YarekTyshchenko/KJ-22/box/export.FCStd

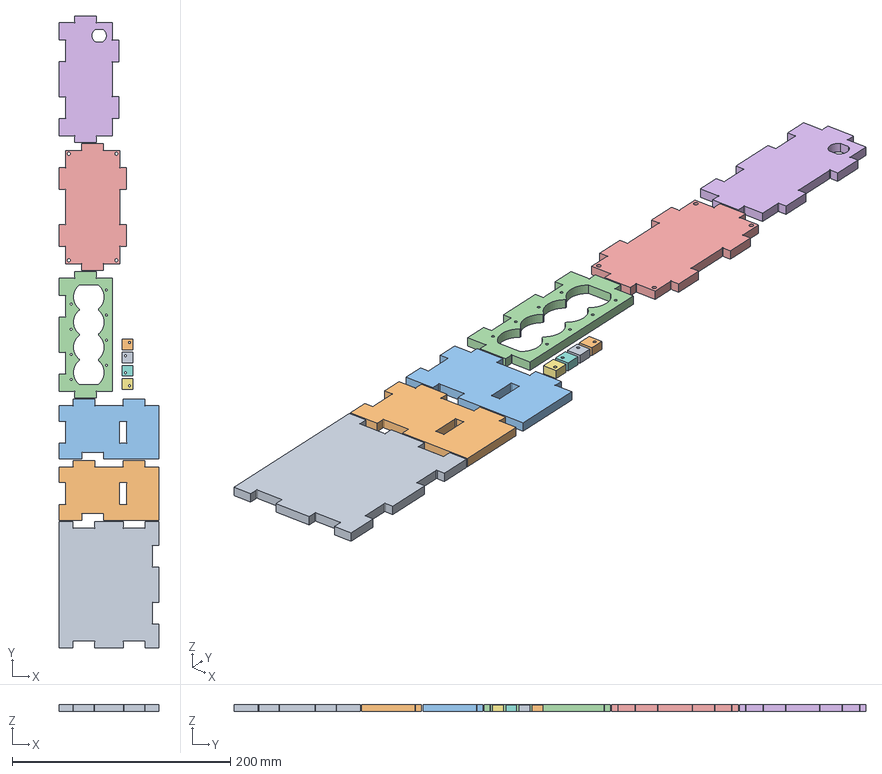
[picture p1: CAD file, 2021-09-22]
box/export.FCStd
92.0 x 579.0 x 6.00 mm
test
test001
test002
test003
test004
test005
test006
test007
test008
test009
