YarekTyshchenko/KJ-22/box/Box-test.FCStd

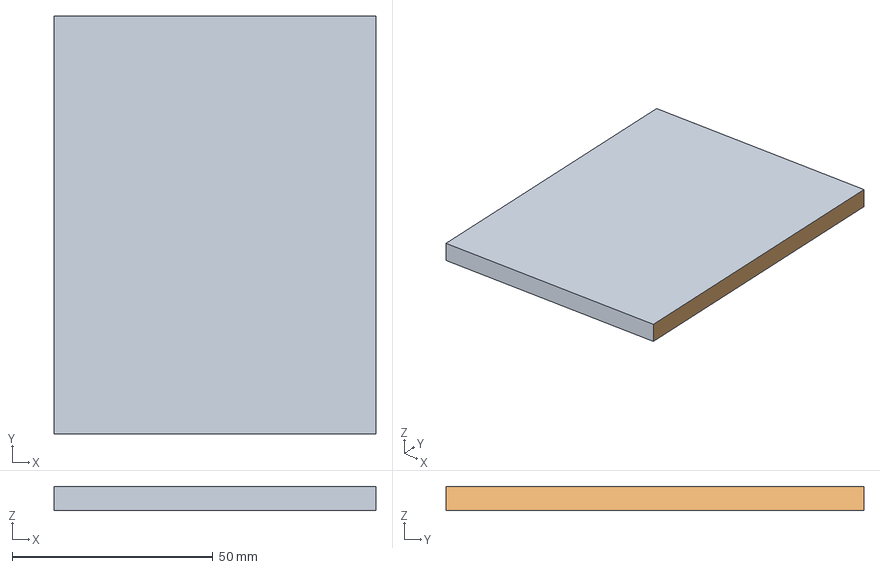
[picture p2: CAD file, 2021-09-22]
box/Box-test.FCStd
80.0 x 104.0 x 6.00 mm
bottom_panel002
