YarekTyshchenko/KJ-22/box/Foo.FCStd

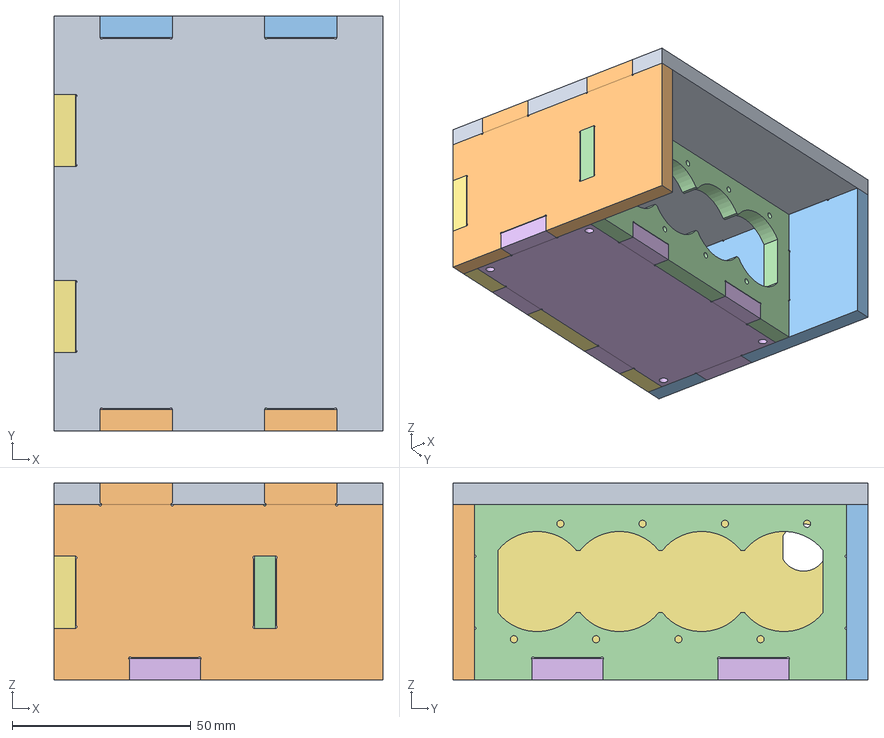
[picture p3: CAD file, 2021-05-18]
box/Foo.FCStd
92.0 x 116.0 x 55.0 mm
top_panel001_tab
right_panel001_tab
left_panel001_tab
Front panel
Corner Bracket
Bottom Panel
Back Panel
Corner Bracket (Mirror #1)
Corner Bracket (Mirror #2)
Corner Bracket (Mirror #3)
