YarekTyshchenko/KJ-22/box/Box 6mm.FCStd

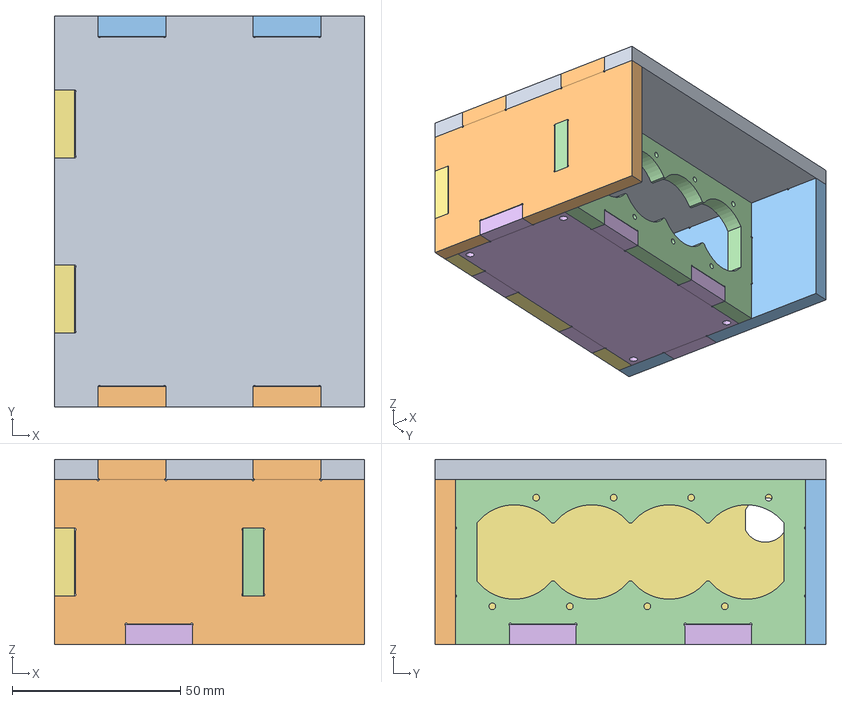
[picture p4: CAD file, 2021-05-18]
box/Box 6mm.FCStd
92.0 x 116.0 x 55.0 mm
top_panel001_tab
right_panel001_tab
left_panel001_tab
Front panel
Corner Bracket
Bottom Panel
Back Panel
Corner Bracket (Mirror #1)
Corner Bracket (Mirror #2)
Corner Bracket (Mirror #3)
