YarekTyshchenko/KJ-22/box/box_6mm Walnut.dxf

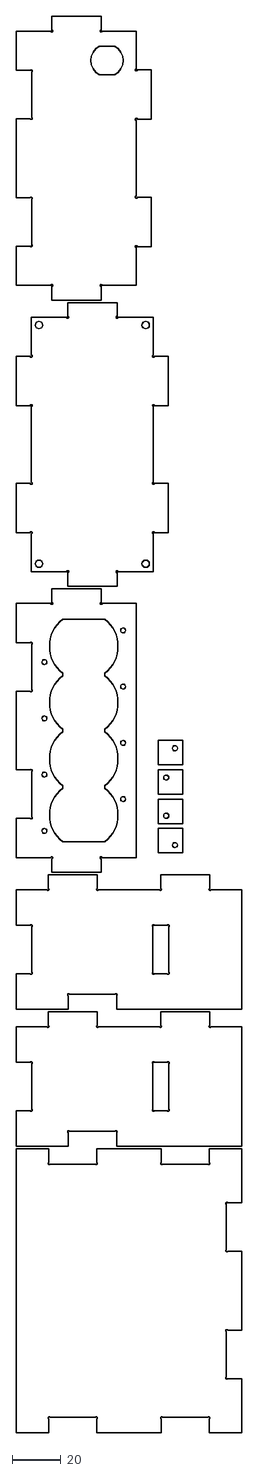
[picture p5: CAD file, 2021-05-18]
box/box_6mm Walnut.dxf
92.0 x 579.0
