YarekTyshchenko/KJ-22/box/Box 5.7mm.FCStd

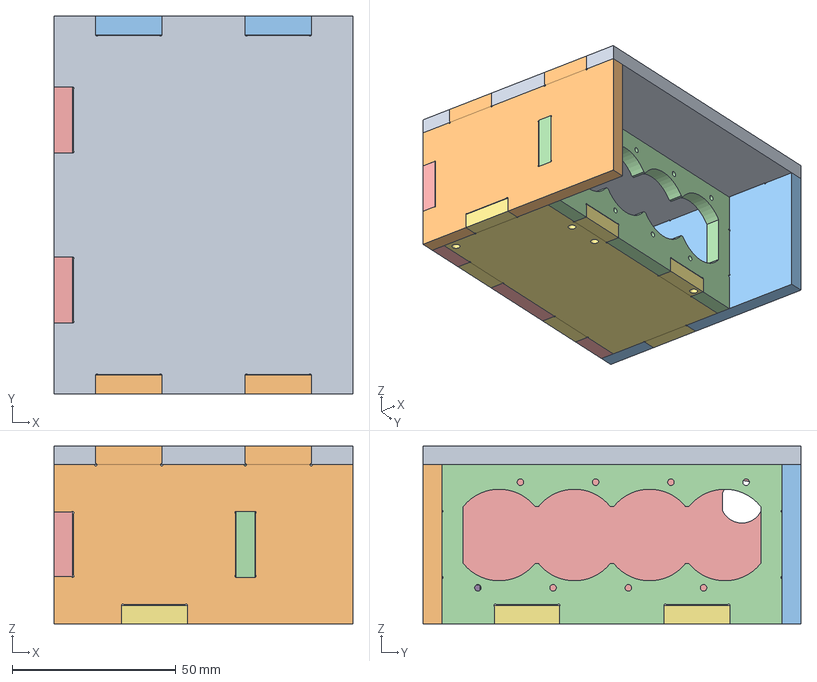
[picture p6: CAD file, 2021-05-18]
box/Box 5.7mm.FCStd
91.4 x 115.4 x 54.4 mm
top_panel001_tab
right_panel001_tab
left_panel001_tab
Front panel
Corner Bracket
Bottom Panel
