YarekTyshchenko/KJ-22/(list of files, cad)

Other CAD files:
box/laser-cut-box.FCStd
box/KJ-22 project box.skp
box/box_test.dxf
box/laser-cut-box.blend
