YarekTyshchenko/KJ-22/main_v2.brd

## EAGLE design main_v2.brd (2021-04-18)

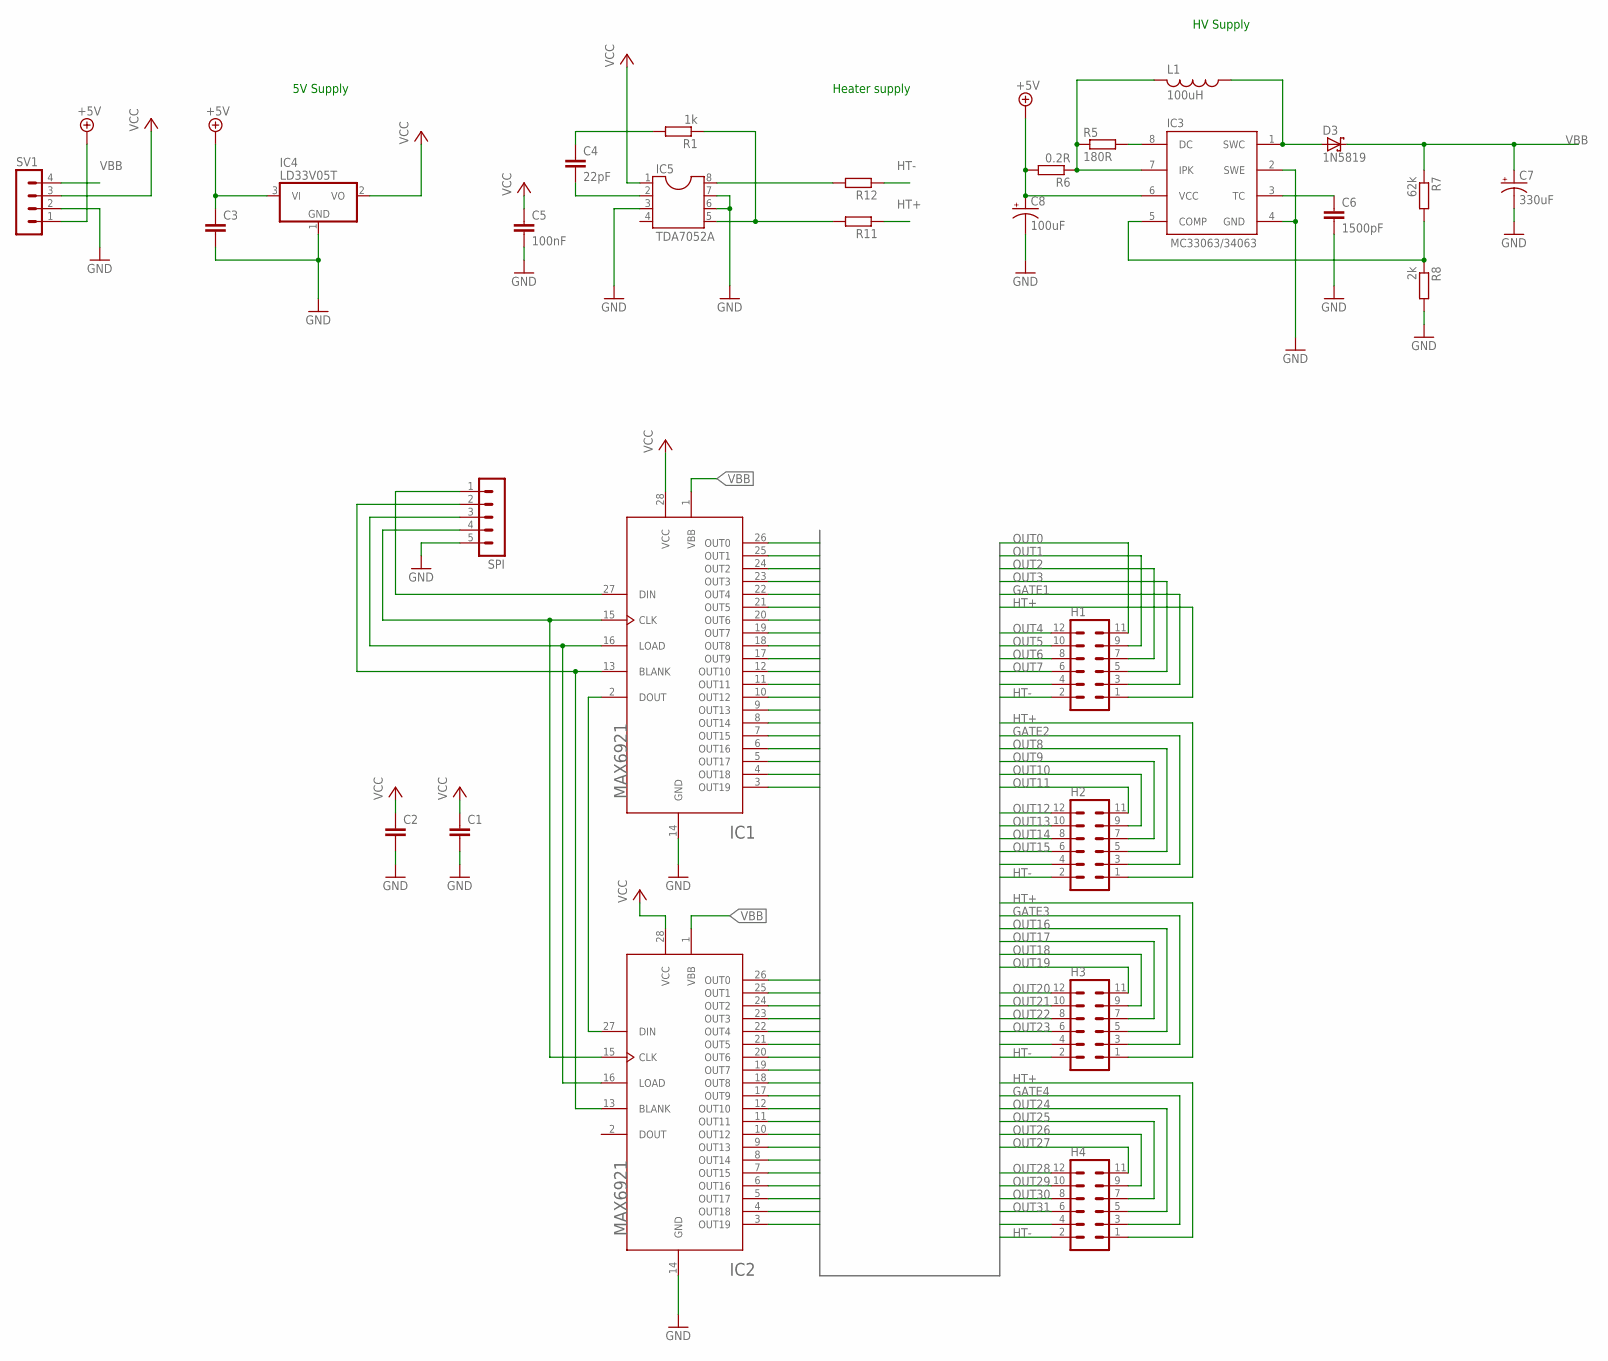
[picture p7: schematic main_v2.sch]

Parts:
C1, C2, C3: C-EU025-025X050; C025-025X050
C4: 22pF; C025-025X050
C5: 100nF; C025-025X050
C6: 1500pF; C025-025X050
C7: 330uF; E3,5-8
C8: 100uF; E2,5-5
D3: 1N5819; DO35-7
H1, H2, H3, H4: MA06-2
IC1, IC2: MAX6921; PLCC-S28
IC3: MC33063; DIL08
IC4: LD33V05T; TO220H
IC5: TDA7052A; DIL08
L1: 100uH; 6000-XXXX-RC
R1: 1k; 0204/7
R5: 180R; 0204/7
R6: 0.2R; 0207/10
R7: 62k; 0204/7
R8: 2k; 0204/7
R11, R12: R-EU_0204/7; 0204/7
SPI: MA05-1
SV1: MA04-1

Connections:
+5V: C3.1, C8.+, IC3.6 (VCC), IC4.3 (VI), R6.2, SV1.1
GATE1: H1.3, IC2.12 (OUT10)
GATE2: H2.3, IC2.18 (OUT8)
GATE3: H3.3, IC1.12 (OUT10)
GATE4: H4.3, IC1.25 (OUT1)
GND: C1.2, C2.2, C3.2, C5.2, C6.2, C7.-, C8.-, IC1.14 (GND), IC2.14 (GND), IC3.2 (SWE), IC3.4 (GND), IC4.1 (GND), IC5.3, IC5.6, IC5.7, R8.2, SPI.5, SV1.2
HT+: H1.1, H2.1, H3.1, H4.1, R11.1
HT-: H1.2, H2.2, H3.2, H4.2, R12.1
MOSI: IC1.27 (DIN), SPI.1
unnamed: IC1.2 (DOUT), IC2.27 (DIN)
unnamed: IC5.8, R12.2
unnamed: IC1.13 (BLANK), IC2.13 (BLANK), SPI.2
unnamed: IC1.16 (LOAD), IC2.16 (LOAD), SPI.3
unnamed: C6.1, IC3.3 (TC)
unnamed: IC5.5, R1.1, R11.2
unnamed: D3.A, IC3.1 (SWC), L1.1
unnamed: IC3.7 (IPK), L1.2, R5.1, R6.1
unnamed: IC3.8 (DC), R5.2
unnamed: C4.2, IC5.2
unnamed: IC3.5 (COMP), R7.2, R8.1
unnamed: C4.1, R1.2
OUT0: H1.11, IC2.10 (OUT12)
OUT1: H1.9, IC2.7 (OUT15)
OUT2: H1.7, IC2.5 (OUT17)
OUT3: H1.5, IC2.11 (OUT11)
OUT4: H1.12, IC2.9 (OUT13)
OUT5: H1.10, IC2.8 (OUT14)
OUT6: H1.8, IC2.6 (OUT16)
OUT7: H1.6, IC2.3 (OUT19)
OUT8: H2.5, IC2.21 (OUT5)
OUT9: H2.7, IC2.23 (OUT3)
OUT10: H2.9, IC2.25 (OUT1)
OUT11: H2.11, IC2.19 (OUT7)
OUT12: H2.12, IC2.20 (OUT6)
OUT13: H2.10, IC2.26 (OUT0)
OUT14: H2.8, IC2.24 (OUT2)
OUT15: H2.6, IC2.22 (OUT4)
OUT16: H3.5, IC1.11 (OUT11)
OUT17: H3.7, IC1.8 (OUT14)
OUT18: H3.9, IC1.9 (OUT13)
OUT19: H3.11, IC1.10 (OUT12)
OUT20: H3.12, IC1.7 (OUT15)
OUT21: H3.10, IC1.6 (OUT16)
OUT22: H3.8, IC1.5 (OUT17)
OUT23: H3.6, IC1.3 (OUT19)
OUT24: H4.5, IC1.23 (OUT3)
OUT25: H4.7, IC1.21 (OUT5)
OUT26: H4.9, IC1.22 (OUT4)
OUT27: H4.11, IC1.19 (OUT7)
OUT28: H4.12, IC1.20 (OUT6)
OUT29: H4.10, IC1.18 (OUT8)
OUT30: H4.8, IC1.17 (OUT9)
OUT31: H4.6, IC1.24 (OUT2)
SCK: IC1.15 (CLK), IC2.15 (CLK), SPI.4
SPARE1: H1.4, IC2.4 (OUT18)
SPARE2: H2.4, IC2.17 (OUT9)
SPARE3: H3.4, IC1.4 (OUT18)
SPARE4: H4.4, IC1.26 (OUT0)
VBB: C7.+, D3.C, IC1.1 (VBB), IC2.1 (VBB), R7.1, SV1.4
VCC: C1.1, C2.1, C5.1, IC1.28 (VCC), IC2.28 (VCC), IC4.2 (VO), IC5.1, SV1.3

Notes on the sheet:
Heater supply
HV Supply
5V Supply

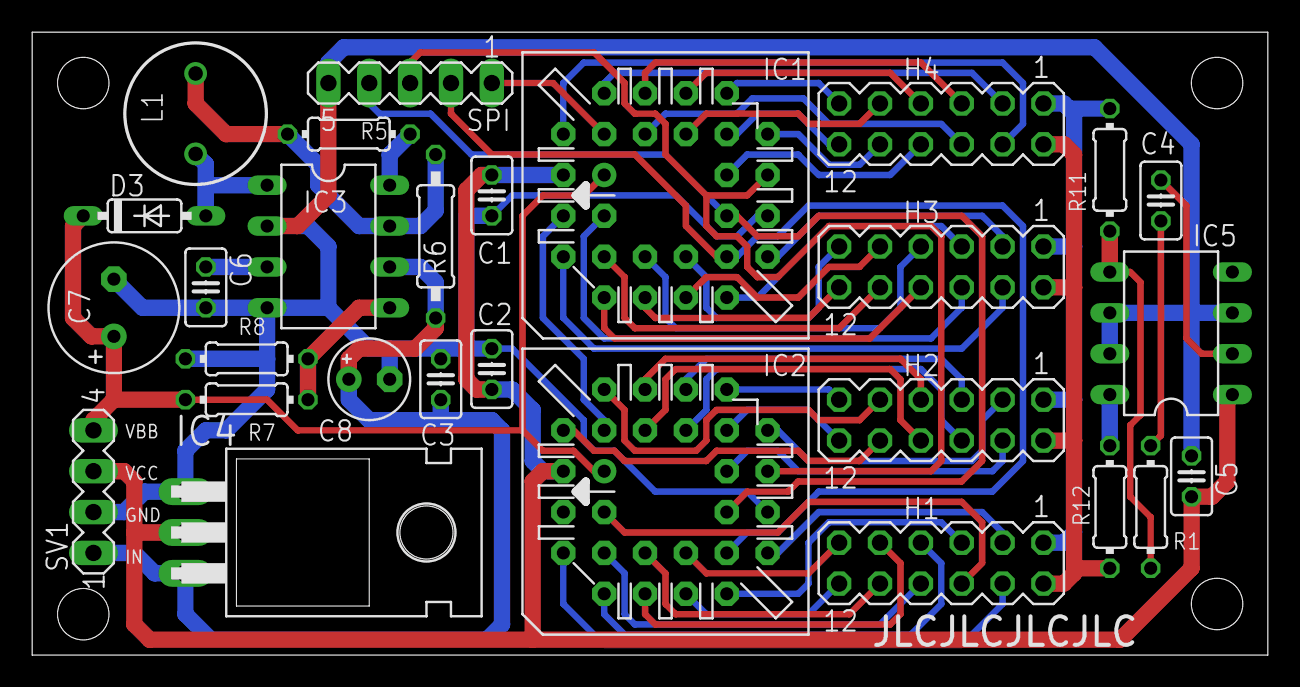
[picture p8: board main_v2.brd from above]

Board: 2 copper layers, 76.8 x 38.7 mm, 28 parts (0 on the bottom side), 60 nets.
