YarekTyshchenko/KJ-22/main_v1.brd

## EAGLE design main_v1.brd (2018-06-11, an earlier design)

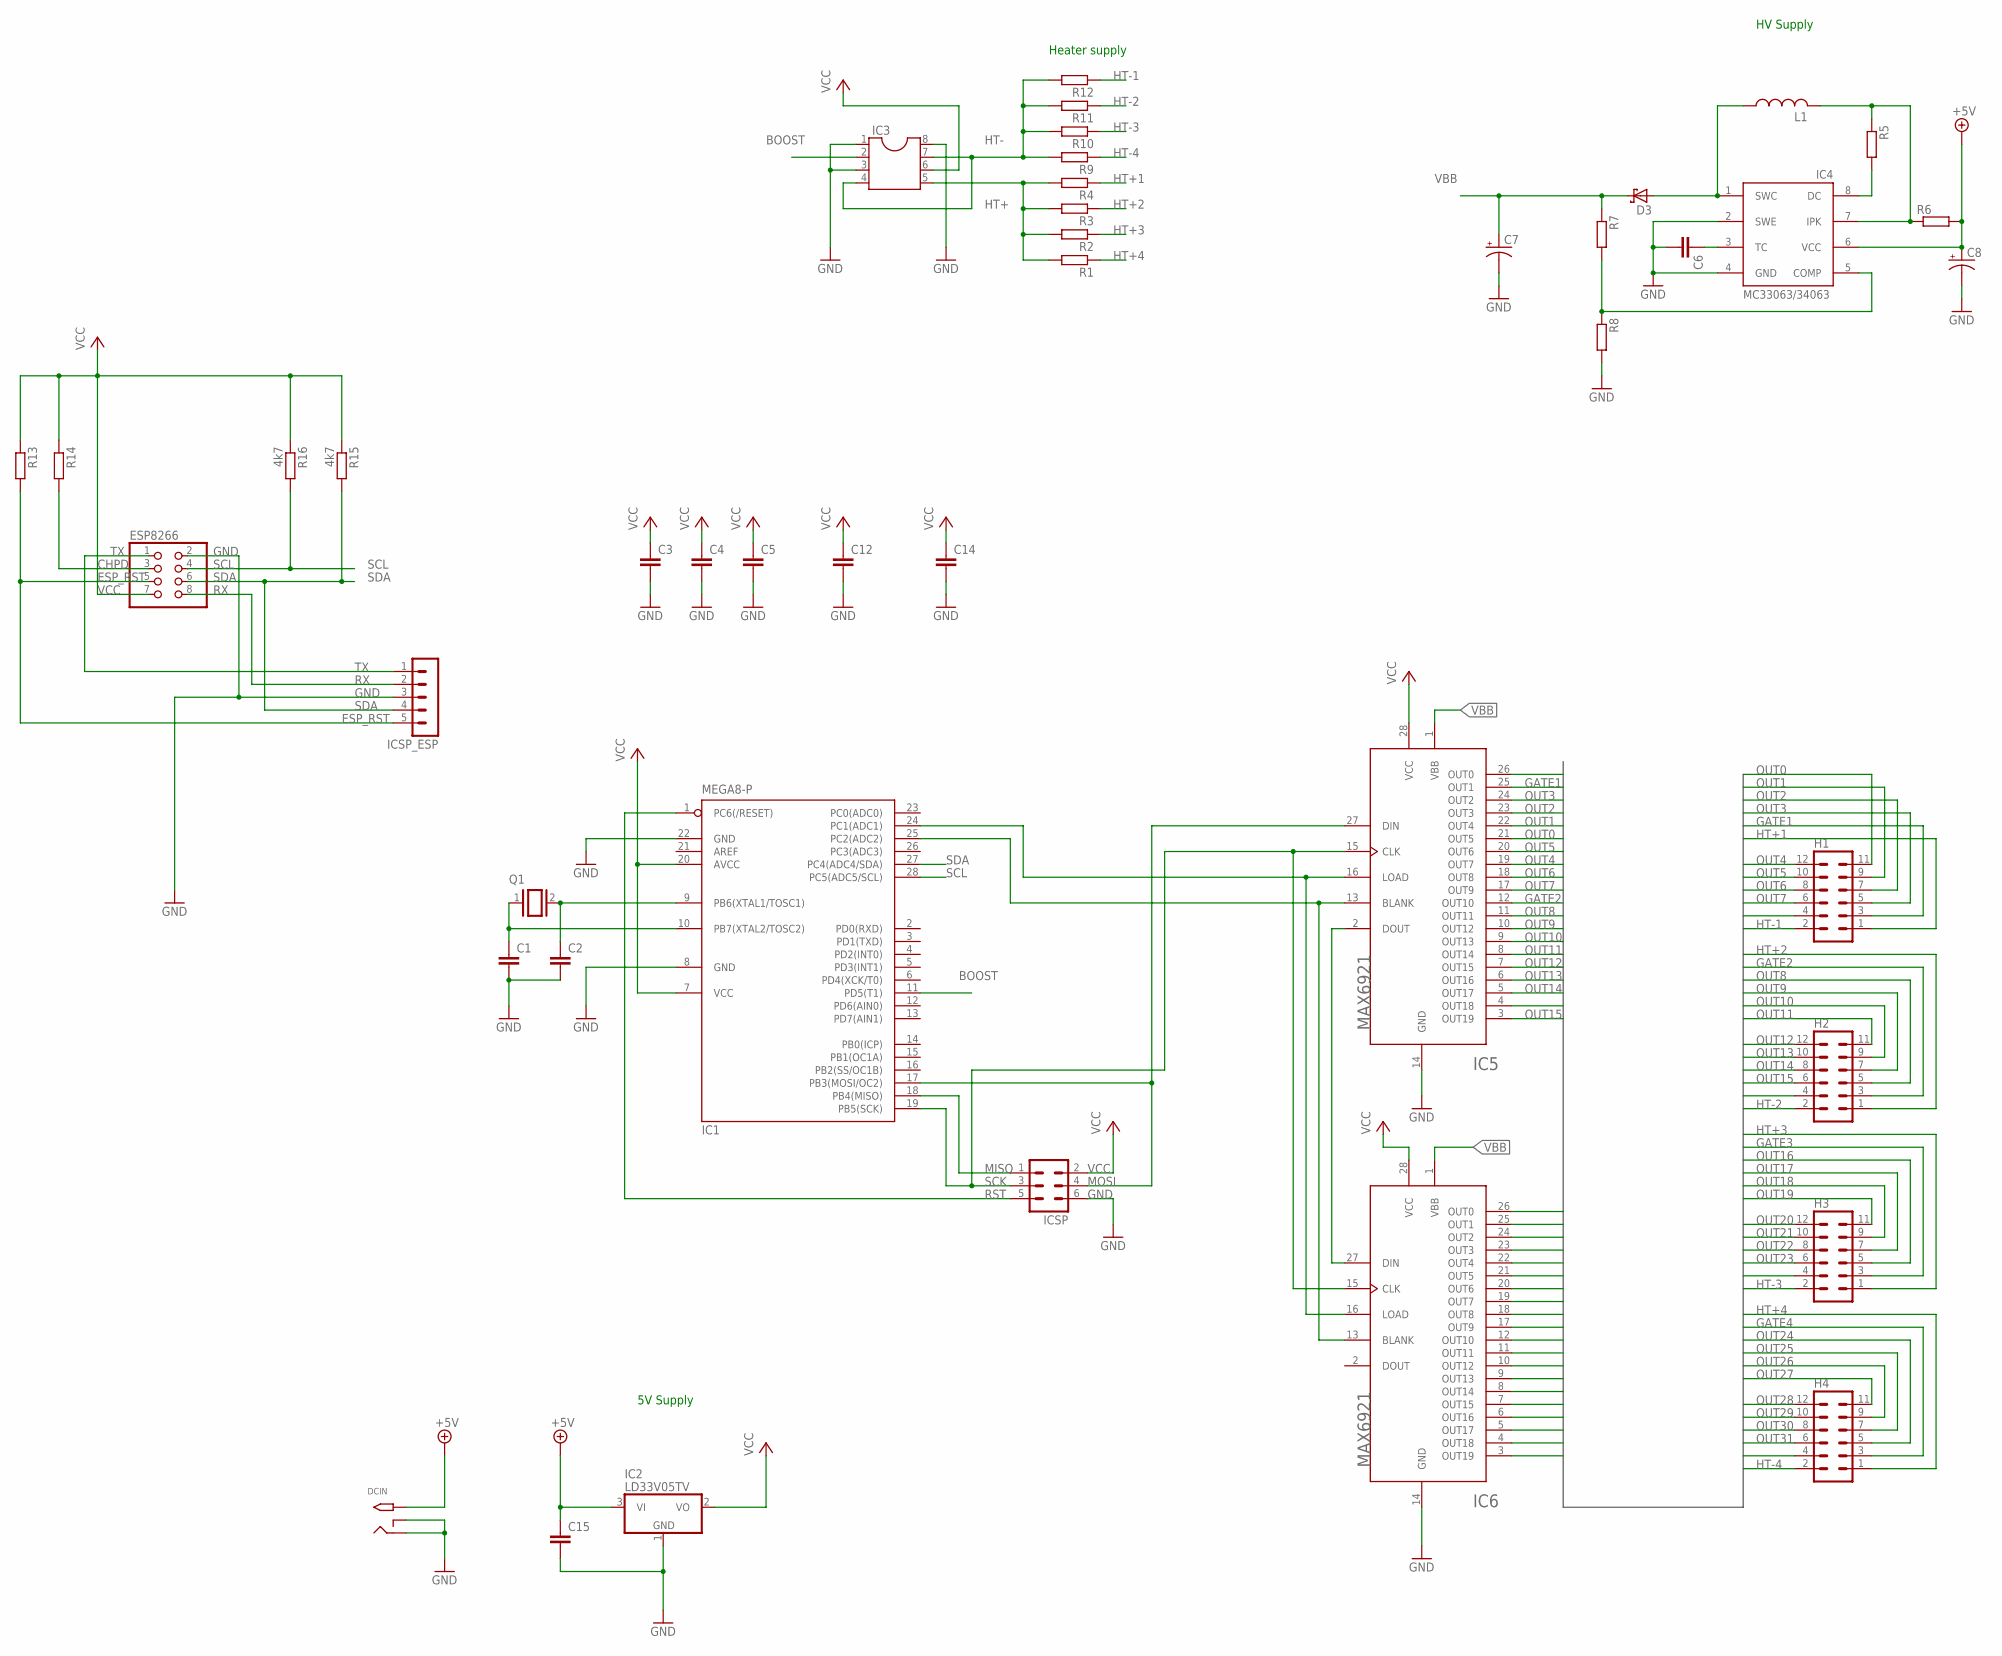
[picture p9: schematic main_v1.sch]

Parts:
C1, C2: C2.5/2; C2.5-2
C3, C4, C5, C6, C12, C14, C15: C-EU025-025X050; C025-025X050
C7: CPOL-USE3.5-8; E3,5-8
C8: CPOL-USE2.5-5; E2,5-5
D3: SCHOTTKY-DIODEDO35-7; DO35-7
DCIN: 2.1MMJACKTHM; PJ-102A
ESP8266: PINHD-2X4; 2X04
H1, H2, H3, H4: MA06-2
IC1: MEGA8-P; DIL28-3
IC2: LD33V05TV; TO220V
IC3: DIL8; DIL08
IC4: MC33063/MC34063P; DIL08
IC5, IC6: MAX6921; PLCC-S28
ICSP: MA03-2
ICSP_ESP: MA05-1
L1: L-US6000-XXX-RC; 6000-XXXX-RC
Q1: XTAL/S; QS
R1, R2, R3, R4, R5, R6, R7, R8, R9, R10, R11, R12, R14: R-EU_0204/7; 0204/7
R13: R-EU_0207/10; 0207/10
R15, R16: 4k7; 0204/7

Connections:
+5V: C8.+, C15.1, DCIN.TIP, IC2.3 (VI), IC4.6 (VCC), R6.2
BOOST: IC1.11 (PD5(T1)), IC3.2
CHPD: ESP8266.3, R14.2
ESP_RST: ESP8266.5, ICSP_ESP.5, R13.2
GATE1: H1.3, IC5.25 (OUT1)
GATE2: H2.3, IC5.12 (OUT10)
GATE3: H3.3, IC6.25 (OUT1)
GATE4: H4.3, IC6.12 (OUT10)
GND: C1.2, C2.2, C3.2, C4.2, C5.2, C6.2, C7.-, C8.-, C12.2, C14.2, C15.2, DCIN.RING, DCIN.RING_SW, ESP8266.2, IC1.8 (GND), IC1.22 (GND), IC2.1 (GND), IC3.1, IC3.3, IC3.8, IC4.2 (SWE), IC4.4 (GND), IC5.14 (GND), IC6.14 (GND), ICSP.6, ICSP_ESP.3, R8.2
HT+: IC3.5, R1.2, R2.2, R3.2, R4.2
HT+1: H1.1, R4.1
HT+2: H2.1, R3.1
HT+3: H3.1, R2.1
HT+4: H4.1, R1.1
HT-: IC3.4, IC3.7, R9.2, R10.2, R11.2, R12.2
HT-1: H1.2, R12.1
HT-2: H2.2, R11.1
HT-3: H3.2, R10.1
HT-4: H4.2, R9.1
MISO: IC1.18 (PB4(MISO)), ICSP.1
MOSI: IC1.17 (PB3(MOSI/OC2)), IC5.27 (DIN), ICSP.4
unnamed: IC5.2 (DOUT), IC6.27 (DIN)
unnamed: C1.1, IC1.10 (PB7(XTAL2/TOSC2)), Q1.1
unnamed: IC1.25 (PC2(ADC2)), IC5.13 (BLANK), IC6.13 (BLANK)
unnamed: IC1.24 (PC1(ADC1)), IC5.16 (LOAD), IC6.16 (LOAD)
unnamed: C6.1, IC4.3 (TC)
unnamed: C2.1, IC1.9 (PB6(XTAL1/TOSC1)), Q1.2
unnamed: D3.A, IC4.1 (SWC), L1.1
unnamed: IC4.7 (IPK), L1.2, R5.1, R6.1
unnamed: IC4.8 (DC), R5.2
unnamed: IC4.5 (COMP), R7.2, R8.1
OUT0: H1.11, IC5.21 (OUT5)
OUT1: H1.9, IC5.22 (OUT4)
OUT2: H1.7, IC5.23 (OUT3)
OUT3: H1.5, IC5.24 (OUT2)
OUT4: H1.12, IC5.19 (OUT7)
OUT5: H1.10, IC5.20 (OUT6)
OUT6: H1.8, IC5.18 (OUT8)
OUT7: H1.6, IC5.17 (OUT9)
OUT8: H2.5, IC5.11 (OUT11)
OUT9: H2.7, IC5.10 (OUT12)
OUT10: H2.9, IC5.9 (OUT13)
OUT11: H2.11, IC5.8 (OUT14)
OUT12: H2.12, IC5.7 (OUT15)
OUT13: H2.10, IC5.6 (OUT16)
OUT14: H2.8, IC5.5 (OUT17)
OUT15: H2.6, IC5.3 (OUT19)
OUT16: H3.5, IC6.24 (OUT2)
OUT17: H3.7, IC6.23 (OUT3)
OUT18: H3.9, IC6.22 (OUT4)
OUT19: H3.11, IC6.21 (OUT5)
OUT20: H3.12, IC6.19 (OUT7)
OUT21: H3.10, IC6.20 (OUT6)
OUT22: H3.8, IC6.18 (OUT8)
OUT23: H3.6, IC6.17 (OUT9)
OUT24: H4.5, IC6.11 (OUT11)
OUT25: H4.7, IC6.10 (OUT12)
OUT26: H4.9, IC6.9 (OUT13)
OUT27: H4.11, IC6.8 (OUT14)
OUT28: H4.12, IC6.7 (OUT15)
OUT29: H4.10, IC6.6 (OUT16)
OUT30: H4.8, IC6.5 (OUT17)
OUT31: H4.6, IC6.3 (OUT19)
RST: IC1.1 (PC6(/RESET)), ICSP.5
RX: ESP8266.8, ICSP_ESP.2
SCK: IC1.19 (PB5(SCK)), IC5.15 (CLK), IC6.15 (CLK), ICSP.3
SCL: ESP8266.4, IC1.28 (PC5(ADC5/SCL)), R16.2
SDA: ESP8266.6, IC1.27 (PC4(ADC4/SDA)), ICSP_ESP.4, R15.2
SPARE1: H1.4, IC5.26 (OUT0)
SPARE2: H2.4, IC5.4 (OUT18)
SPARE3: H3.4, IC6.26 (OUT0)
SPARE4: H4.4, IC6.4 (OUT18)
TX: ESP8266.1, ICSP_ESP.1
VBB: C7.+, D3.C, IC5.1 (VBB), IC6.1 (VBB), R7.1
VCC: C3.1, C4.1, C5.1, C12.1, C14.1, ESP8266.7, IC1.7 (VCC), IC1.20 (AVCC), IC2.2 (VO), IC3.6, IC5.28 (VCC), IC6.28 (VCC), ICSP.2, R13.1, R14.1, R15.1, R16.1

Notes on the sheet:
Heater supply
HV Supply
5V Supply

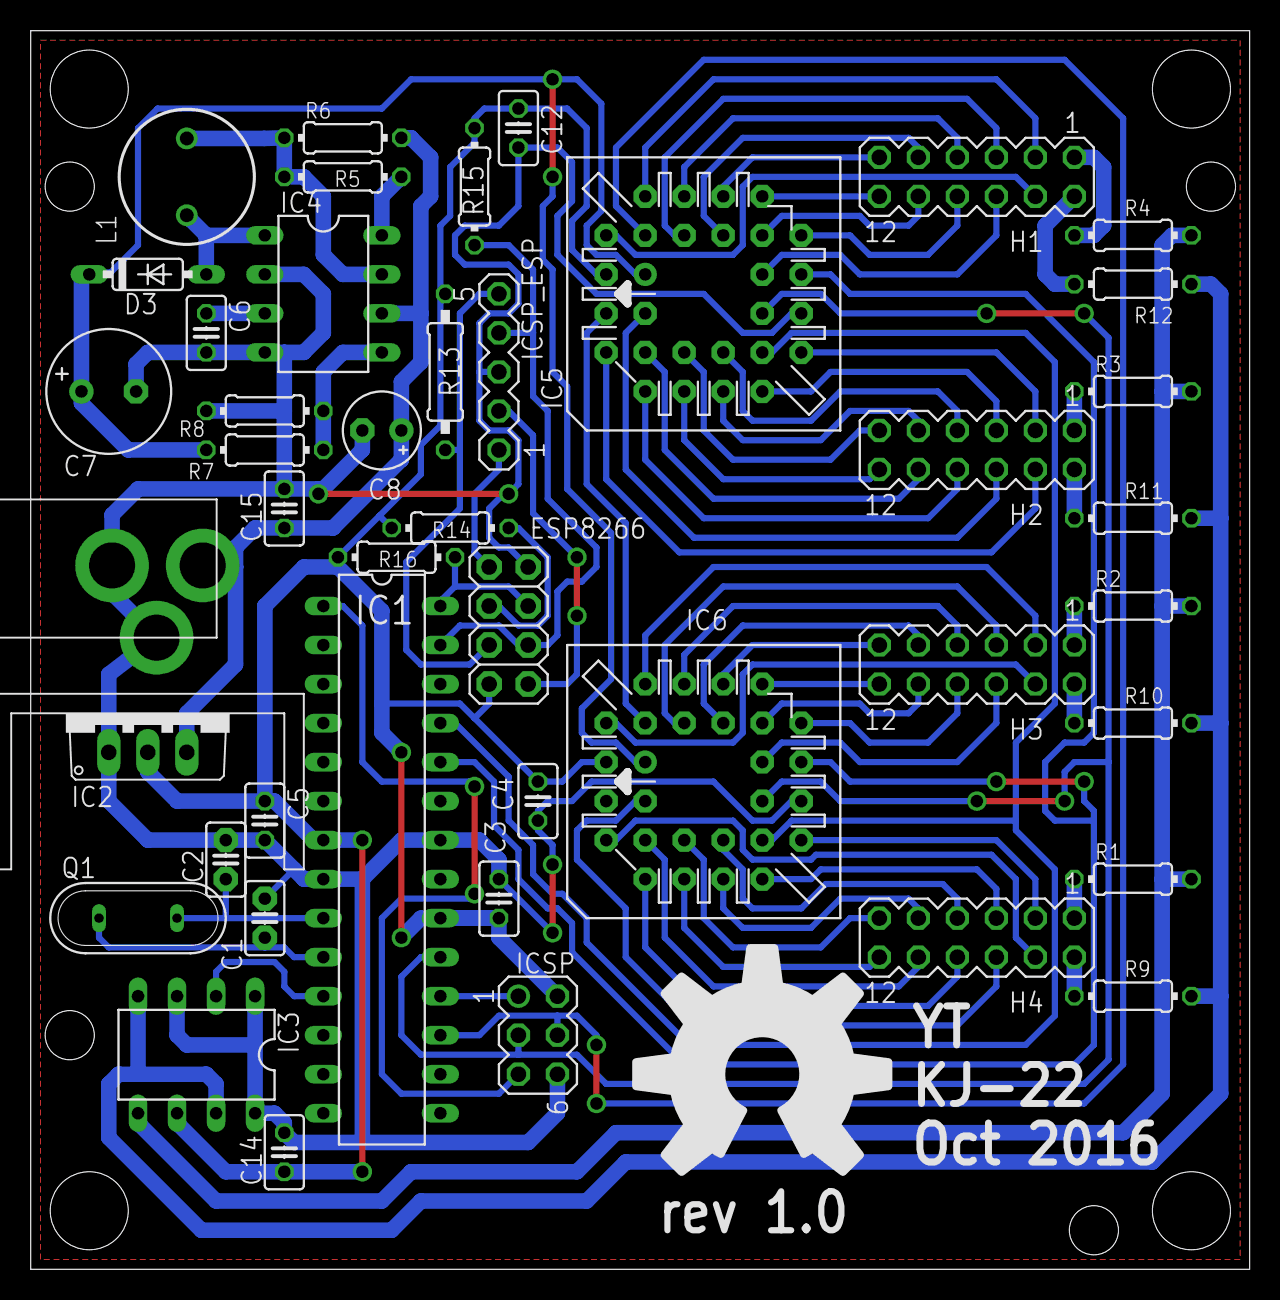
[picture p10: board main_v1.brd from above]

Board: 2 copper layers, 79.4 x 80.6 mm, 44 parts (0 on the bottom side), 75 nets.
