YarekTyshchenko/KJ-22/(commit log)

2016-10-17 Holes and logo fix
    [main_v1.brd, main_v1.sch]
2016-10-18 Added better OSHW logo
    [main_v1.brd, main_v1.sch]
2016-10-18 Fix OSHPark complaints
    [main_v1.brd]
2017-06-12 WIP Add a header for future expansion
    Possible network connectivity, not sure how this is supposed to work
    [main_v1.brd]
2018-06-10 Prepare to move the atmega
    [main_v1.brd, main_v1.sch]
2018-06-10 Move ESP ICSP header, and bits into the board
    [main_v1.brd, main_v1.sch]
2018-06-11 Fix ESP socket connections
    [main_v1.brd, main_v1.sch]
2018-06-11 Fix some trace widths
    [main_v1.brd, main_v1.sch]
2018-06-11 Replace LM7805 with LD33v
    [main_v1.brd, main_v1.sch]
2018-06-11 swapped a few ground traces around
    [main_v1.brd]
2018-06-11 Move the ground pours back
    [main_v1.brd]
2018-06-11 Align traces
    [main_v1.brd]
2019-01-28 Add box to repo
    [KJ-22 project box.skp]
2021-04-15 Add a smaller version of the board
    [main_v2.brd, main_v2.sch]
2021-04-15 Pracical modifications
    [main_v2.brd, main_v2.sch]
2021-04-15 Try wiring a few routes
    [main_v2.brd, main_v2.sch]
2021-04-16 Wire most of the board
    [main_v2.brd, main_v2.sch]
2021-04-17 More work on the board
    [main_v2.brd, main_v2.sch]
2021-04-18 Nearly there
    [main_v2.brd, main_v2.sch]
2021-04-18 Try SPI header vertically
    [main_v2.brd, main_v2.sch]
2021-04-18 Well, its finished
    [main_v2.brd, main_v2.sch]
2021-04-18 Final Touches
    [main_v2.brd]
2021-05-15 Add box
    [Foo.FCStd]
2021-05-15 Make box work
    [Foo.FCStd]
2021-05-15 All the holes are there
    Maybe except some mounting pilot holes
    [Foo.FCStd]
2021-05-18 Finished all the holes and measures
    [Foo.FCStd]
2021-05-18 Add 5.7mm and 6mm designs
    [Box 5.7mm.FCStd, Box 6mm.FCStd]
2021-05-18 Add square mounting brackets, and dxf
    [Box 6mm.FCStd, box_6mm Walnut.dxf]
2021-05-18 Some sort of changes
    [Box 6mm.FCStd]
2021-05-18 Dont know why this is modified
    [Foo.FCStd]
2021-09-22 Add various laser cut box files
    [Box-test.FCStd, box_test.dxf, export.FCStd, laser-cut-box.FCStd, laser-cut-box.blend]
2021-09-27 Fix the brightness logic
    [KJ-22.ino]
2021-11-17 Fix Settings overwriting each other
    [KJ-22.ino]
